HarrisonJaffe/CNC-Mill/Parts_List/3 Axis CNC Mill.xlsx

Part Name | Links | Price per unit | Quantity to Buy
Z axis Motor | https://www.amazon.com/Iverntech-Stepper-Integrated-Printers-Machine/dp/B07YQLVZ86?s=industrial | 35.79 | 2
Spindle | https://www.amazon.com/Daedalus-Brushless-Spindle-Switching-Engraving/dp/B083V11QY2 | 179.99 | 1
Bristles for Dust Shoe | https://uglydogwoodshop.com/products/big-suck-brush-1-1-5-2?variant=45041747001599 | 5.89 | 1
N35 Magnets for Dust Shoe | Amazon.com: 7x2mm Magnets (https://www.amazon.com/50Pcs-N35-Neodymium-Magnets-7mm/dp/B0DSWKKZXP?sp_csd=d2lkZ2V0TmFtZT1zcF9hdGY) | 9.99 | 1
Z Axis Alignment Rods | https://www.amazon.com/uxcell-Bearings-Support-Machine-Printer/dp/B0DH26T3KJ | 18.19 | 1
X Axis 4040 Extrusion 600mm | VEVOR T Slotted Aluminum Extrusions – 4PCS, 39.4in, 6063-T5 (https://www.vevor.com/linear-guide-rail-c_10531/4pcs-39-4-in-1000-mm-t-slot-4040-aluminum-extrusion-anodized-linear-rail-p_010856153247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) | 35.90 | 1
X + Y Axis Bearings 600mm Travel | https://www.amazon.com/MGN12H-Linear-Carriage-Printer-Machines/dp/B0BYVCLSHJ?sp_csd=d2lkZ2V0TmFtZT1zcF9hdGY | 32.99 | 4
Aluminum 6061-T6 Side Panels 15mm Thick | Needs Machining | ?? | 2
M3 Locking Nuts | https://www.amazon.com/M3-Locknuts-Self-Lock-Stainless-Self/dp/B0D146SHYF?pid=Qqj7Hdt&s=industrial | 5.99 | 1
M5 Locking Nuts | Vifmy 190 Pack M5-0.8mm Nylon Insert Hex Lock Nuts, 304 Stainless Steel A2-70 Locknuts,Standard Metric Thread Nylock Nuts: Amazon.com: Industrial & Scientific (https://www.amazon.com/Vifmy-M5-0-8mm-Stainless-Locknuts-Standard/dp/B0CPJCTLRP?adgrpid=1343603773933356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) | 9.99 | 1
Threaded rods | Amazon.com: T8 Lead Screw Thread 8mm Trapezoidal Rod Lead 1mm 2mm 4mm 8mm Length 100mm to 800mm CNC 3D Printer with Brass Nut (Color : Pitch 2mm Lead 4mm, Guide Length : 750mm) : Industrial & Scientific (https://www.amazon.com/Screw-Thread-Trapezoidal-Length-Printer/dp/B0B6BSFDM9?th=1) | 38.90 | 1
T8 Nuts for motion | ReliaBot 2PCs Tr8x8 Lead Screw Brass Nut (Acme Thread, 2mm Pitch, 4 Start, 8mm Lead) for Diameter 8mm T8 Lead Screw of 3D Printer Z Axis: Amazon.com: Industrial & Scientific (https://www.amazon.com/ReliaBot-Thread-Starts-Diameter-Printer/dp/B079HQ386R) | 4.99 | 1
4080 Aluminum extrusion 600mm | Amazon.com: 4080 T Slot Aluminum Extrusion for 3D Printer Parts and CNC DIY Black 1500mmX2 : Industrial & Scientific (https://www.amazon.com/Aluminum-Extrusion-Printer-Parts-1500mmX2/dp/B0BXNLK6XR) | 56.99 | 1
4080 Aluminum Extrusion 700mm | Amazon.com: 4080 T Slot Aluminum Extrusion for 3D Printer Parts and CNC DIY Black 600mmX2 : Industrial & Scientific (https://www.amazon.com/Aluminum-Extrusion-Printer-Parts-1500mmX2/dp/B0BXNL7TGS) | 62.99 | 1
M3 T nuts | Amazon.com: uxcell T Nuts, 30pcs - Nickel Plated Carbon Steel T Slot Bolts, 4040 Series M8 Hammer Head Fastener, Sliding T Nuts for Aluminum Extrusion Profile (Silver) : Industrial & Scientific (https://www.amazon.com/uxcell-Nuts-30pcs-Fastener-Extrusion/dp/B0C9QV8MN9?hvadid=79920942005888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) | 20.29 | 2+
90 Degree brackets | Amazon.com: SeekLiny 26pcs 4040 Corner Angel Bracket Connector Aluminum Extrusion Hardware V-Slot T-Slot Accessories with T Nuts and Screws for 4040 Aluminum Profile 3D Printer Frame Accessories Black : Industrial & Scientific (https://www.amazon.com/SeekLiny-Connector-Aluminum-Extrusion-Accessories/dp/B0CLXVBQZJ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) | 27.99 | 1
5mm to 8mm coupler | 5mm - 8mm Flexible Jaw Coupling 20x25mm CNC Stepper Motor Shaft Coupler - MH2025-5-8 | StepperOnline (https://www.omc-stepperonline.com/5mm-8mm-flexible-jaw-coupling-20x25mm-cnc-stepper-motor-shaft-coupler-mh2025-5-8) | 3.26 | 1
Y Axis motor | Amazon.com: Iverntech NEMA 17 Stepper Motor with Integrated 150mm T8 Lead Screw for RepRap Prusa i3 3D Printers Z Axis or CNC Machine : Industrial & Scientific (https://www.amazon.com/Iverntech-Stepper-Integrated-Printers-Machine/dp/B07YQR3X1K?s=industrial) | 26.99 | 2026-01-02
KP08 Bearings | uxcell 6 Pcs KP08 Pillow Block Bearing 8mm Bore Zinc Alloy Inner Ball Mounted Bearing Block Insert Bearing Self-Alignment: Amazon.com: Industrial & Scientific (https://www.amazon.com/uxcell-Pillow-Bearing-Mounted-Self-Alignment/dp/B0D2L8M4QR?adgrpid=1333708170469299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) | 9.99 | 2026-02-03
Octopus V1.1 Control Board | https://www.amazon.com/BIGTREETECH-Motherboard-Compatible-Firmware-Raspberry/dp/B094NPRYDP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 | 53.99 | 1
TMC2209 V1.3 | Amazon.com: BIGTREETECH TMC2209 V1.3 Stepper Motor Driver, UART/STEP/DIR Mode, Ultra Silent Stepsticks Drivers with Heatsink for Octopus V1.1/Pro/SKR V1.4 Turbo/SKR 3, Manta M8P/M4P/M5P/MKS Gen L Motherboard 5Pcs : Industrial & Scientific (https://www.amazon.com/BIGTREETECH-DIRECT-TMC2209-Stepsticks-Motherboard/dp/B07ZQ3C1XW) | 26.99 | 1
MEAN WELL LRS-350-24 350.4W 24V | Amazon.com: MEAN WELL LRS-350-24 350.4W 24V 14.6 Amp Single Output Switchable Power : Electronics (https://www.amazon.com/MEAN-WELL-LRS-350-24-350-4W-Switchable/dp/B013ETVO12) | 28.54 | 1
Locktight Thread Locker | https://www.amazon.com/Threadlocker-Strength-Fasteners-Against-Losening/dp/B0DPM5NWRL | 9.99 | 1
E Stop | https://www.amazon.com/Dreyoo-Single-Contact-Electrical-Equipment/dp/B0C9QD72SL?adgrpid=1340307144100681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 | 26.49 | 1
1N148 Diodes | EEEEE 1N4148 Switching Diode (150pcs) 200mA 100V 100 Volt 200 MILLIAMP 0.2A IN4148 4148 Electronic Silicon Diodes: Amazon.com: Industrial & Scientific (https://www.amazon.com/EEEEE-Switching-MILLIAMP-Electronic-Silicon/dp/B0FC289DVH) | 5.99 | 1
Sheilded Wire | SYSTON 18/4 Fire Security Burglar Station Sound Alarm Control Cable Wire,18 AWG 4 Conductors Plenum-Rated CMP/CL3P Shielded 100% Copper Stranded,UV Resistant RoHS for Low Voltage Applications Use: Amazon.com: Tools & Home Improvement (https://www.amazon.com/Cable-Conductors-Plenum-Rated-Resistant-Applications/dp/B0BZT7DPCZ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) | 23.24 | 1
Ferules Crimpin set | SOMELINE Ferrule Crimping Tool Kit, Self-Adjusting Pliers for Wire Ferrules AWG 24-8, With 18 Sizes Insulated and Non-insulated Wire Ferrules Terminals, Square Crimp Connector Assortment Kit - Amazon.com (https://www.amazon.com/SOMELINE%C2%AE-Self-Adjusting-Insulated-Non-insulated-Assortment/dp/B0CM3K91KK) | 24.98 | 1
Drag Chains | https://www.amazon.com/LMioEtool-Plastic-Carrier-Length-Connectors/dp/B07QWKT9RZ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 | 15.49 | 1
NPN Proximaty Diodes NC | Amazon.com: Lzcdelyxiao 5Pcs NO Normally Open NPN Inductive Proximity Sensor Switch M8 Detector 2mm DC6V-36V 3 Wire LJ8A3-2-Z/BX : Industrial & Scientific (https://www.amazon.com/Inductive-Proximity-Sensor-Detection-Switch/dp/B0164GS05K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) | 22.99 | 2
ASA | https://www.amazon.com/Polymaker-Filament-Resistant-Weather-Cardboard/dp/B0BGXCDN1M?keywor | 26.99 | 2+
