HarrisonJaffe/CNC-Mill/(list of files, cad)

Other CAD files:
CNC-Mill.f3z
